ChenSiyun1234/nmos-ldo-board/docs/img/board_angle.png

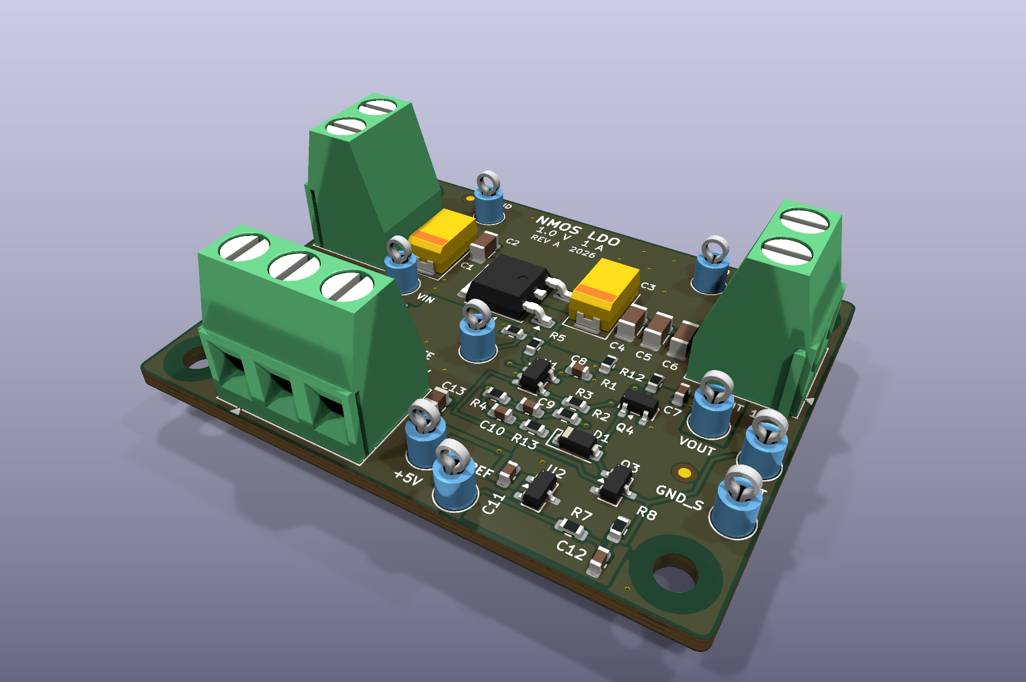
docs/img/board_angle.png
