ChenSiyun1234/nmos-ldo-board/fab/bom.csv

Reference | Qty | Value | Description | Manufacturer | MPN | Footprint
C1,C3 | 2 | 330uF 6.3V | Polymer tantalum capacitor 330uF 6.3V | KEMET | T520D337M006ATE015 | Capacitor_Tantalum_SMD:CP_EIA-7343-31_Kemet-D
C2,C4,C5,C6 | 4 | 47uF 6.3V | Ceramic capacitor 47uF 6.3V | Murata | GRM31CR60J476ME19L | Capacitor_SMD:C_1206_3216Metric
C7,C8,C11,C14 | 4 | 0.1uF | Ceramic capacitor 0.1uF | Murata | GRM188R71C104KA01D | Capacitor_SMD:C_0603_1608Metric
C9 | 1 | 1nF C0G | Ceramic capacitor 1nF C0G | Murata | GRM1885C1H102JA01D | Capacitor_SMD:C_0603_1608Metric
C10 | 1 | 3.3pF C0G | Ceramic capacitor 3.3pF C0G | Murata | GRM1885C1H3R3CA01D | Capacitor_SMD:C_0603_1608Metric
C12 | 1 | 0.47uF | Ceramic capacitor 0.47uF | Murata | GRM188R71C474KA88D | Capacitor_SMD:C_0603_1608Metric
C13 | 1 | 10uF 16V | Ceramic capacitor 10uF 16V | Murata | GRM21BR61C106KE15L | Capacitor_SMD:C_0805_2012Metric
D1 | 1 | 1N4148W | Switching diode, 100 V, 300 mA, SOD-123 | Diodes Incorporated | 1N4148W-7-F | Diode_SMD:D_SOD-123
J1 | 1 | VIN 1.5-2.0 V | Screw terminal, 2 pole, 5.08 mm | Phoenix Contact | 1715721 | TerminalBlock_Phoenix:TerminalBlock_Phoenix_MKDS-1,5-2-5.08_1x02_P5.08mm_Horizontal
J2 | 1 | VOUT 1.0 V 1 A | Screw terminal, 2 pole, 5.08 mm | Phoenix Contact | 1715721 | TerminalBlock_Phoenix:TerminalBlock_Phoenix_MKDS-1,5-2-5.08_1x02_P5.08mm_Horizontal
J3 | 1 | BIAS 5 V / EN | Screw terminal, 3 pole, 5.08 mm | Phoenix Contact | 1715734 | TerminalBlock_Phoenix:TerminalBlock_Phoenix_MKDS-1,5-3-5.08_1x03_P5.08mm_Horizontal
Q1 | 1 | IRLR024N | N-channel logic level MOSFET, 55 V, 65 mohm, DPAK | Infineon | IRLR024NTRPBF | Package_TO_SOT_SMD:TO-252-2
Q2,Q3,Q4 | 3 | BSS138 | 50V Vds, 0.22A Id, N-Channel MOSFET, SOT-23 | onsemi | BSS138 | Package_TO_SOT_SMD:SOT-23
R1 | 1 | 200 | Resistor 200, 0603 | Yageo | RC0603FR-07200RL | Resistor_SMD:R_0603_1608Metric
R2 | 1 | 2.55k 0.1% | Resistor 2.55k 0.1%, 0603 | Yageo | RT0603BRD072K55L | Resistor_SMD:R_0603_1608Metric
R3 | 1 | 10.2k 0.1% | Resistor 10.2k 0.1%, 0603 | Yageo | RT0603BRD0710K2L | Resistor_SMD:R_0603_1608Metric
R4 | 1 | 127k | Resistor 127k, 0603 | Yageo | RC0603FR-07127KL | Resistor_SMD:R_0603_1608Metric
R5 | 1 | 47 | Resistor 47, 0603 | Yageo | RC0603FR-0747RL | Resistor_SMD:R_0603_1608Metric
R6,R9,R13 | 3 | 100k | Resistor 100k, 0603 | Yageo | RC0603FR-07100KL | Resistor_SMD:R_0603_1608Metric
R7 | 1 | 5.62k 0.1% | Resistor 5.62k 0.1%, 0603 | Yageo | RT0603BRD075K62L | Resistor_SMD:R_0603_1608Metric
R8 | 1 | 10k 0.1% | Resistor 10k 0.1%, 0603 | Yageo | RT0603BRD0710KL | Resistor_SMD:R_0603_1608Metric
R10 | 1 | 4.7k | Resistor 4.7k, 0603 | Yageo | RC0603FR-074K7L | Resistor_SMD:R_0603_1608Metric
R11,R15 | 2 | 10k | Resistor 10k, 0603 | Yageo | RC0603FR-0710KL | Resistor_SMD:R_0603_1608Metric
R12 | 1 | 22 | Resistor 22, 0603 | Yageo | RC0603FR-0722RL | Resistor_SMD:R_0603_1608Metric
R14 | 1 | 23.2k | Resistor 23.2k, 0603 | Yageo | RC0603FR-0723K2L | Resistor_SMD:R_0603_1608Metric
TP1 | 1 | VIN | Test point, red | Keystone Electronics | 5005 | TestPoint:TestPoint_Keystone_5005-5009_Compact
TP2 | 1 | VOUT | Test point, red | Keystone Electronics | 5005 | TestPoint:TestPoint_Keystone_5005-5009_Compact
TP3 | 1 | GATE | Test point, white | Keystone Electronics | 5007 | TestPoint:TestPoint_Keystone_5005-5009_Compact
TP4 | 1 | VSET | Test point, white | Keystone Electronics | 5007 | TestPoint:TestPoint_Keystone_5005-5009_Compact
TP5 | 1 | VREF | Test point, white | Keystone Electronics | 5007 | TestPoint:TestPoint_Keystone_5005-5009_Compact
TP6 | 1 | +5V | Test point, red | Keystone Electronics | 5005 | TestPoint:TestPoint_Keystone_5005-5009_Compact
TP7 | 1 | EN_INT | Test point, white | Keystone Electronics | 5007 | TestPoint:TestPoint_Keystone_5005-5009_Compact
TP8,TP9 | 2 | GND | Test point, black | Keystone Electronics | 5006 | TestPoint:TestPoint_Keystone_5005-5009_Compact
TP10 | 1 | GND_S | Test point, black | Keystone Electronics | 5006 | TestPoint:TestPoint_Keystone_5005-5009_Compact
U1 | 1 | OPA365 | 50-MHz, Zero-Crossover, Low-Distortion, High CMRR, RRI/O, Single-Supply, SOT-23-5 | Texas Instruments | OPA365AIDBVR | Package_TO_SOT_SMD:SOT-23-5
U2 | 1 | REF3012 | 1.25 V voltage reference, 0.2 % initial accuracy, SOT-23-3 | Texas Instruments | REF3012AIDBZR | Package_TO_SOT_SMD:SOT-23
U3 | 1 | TPS3808G01 | Low-Quiescent-Current, Programmable-Delay Supervisory Circuit, SOT-23-6 | Texas Instruments | TPS3808G01DBVR | Package_TO_SOT_SMD:SOT-23-6
