ChenSiyun1234/nmos-ldo-board/fab/nmos-ldo-board.step

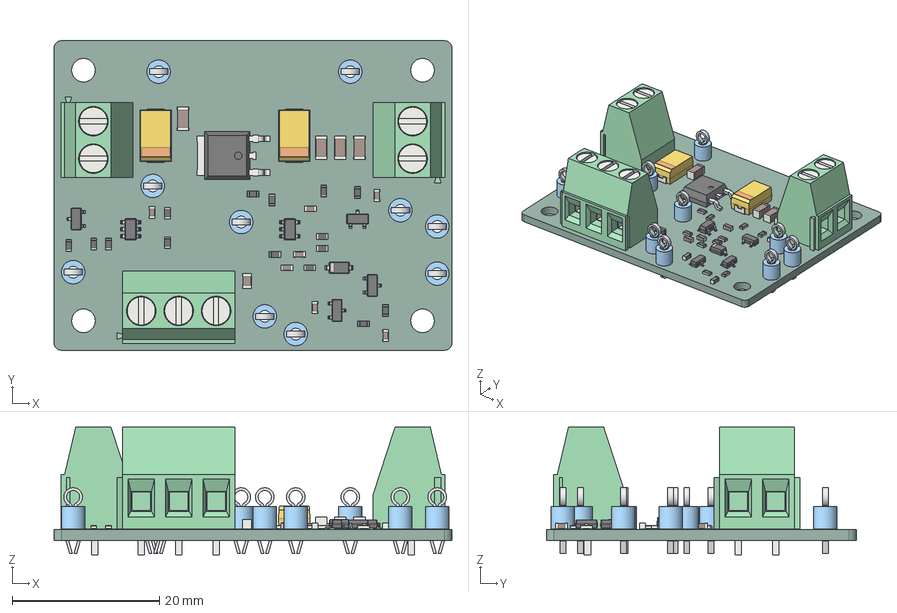
[picture p18: CAD file, 2026-10-25]
fab/nmos-ldo-board.step
54.0 x 42.0 x 17.3 mm
R_0603_1608Metric x 15
SOT-23 x 4
932d09b3-9c39-11ed-93f0-dde97e994e83_part
932d09b4-9c39-11ed-93f0-dde97e994e83_part
932d09b5-9c39-11ed-93f0-dde97e994e83_part
TestPoint_Keystone_5005_5009_Compact_cp x 10
C_0603_1608Metric x 7
C_1206_3216Metric x 4
TerminalBlock_Phoenix_MKDS-1,5-2-5.08_1x02_P5.08mm_Horizontal x 2
SOT-23-6
CP_EIA_7343_31_Kemet_D x 2
SOT-23-5
TerminalBlock_Phoenix_MKDS-1,5-3-5.08_1x03_P5.08mm_Horizontal
C_0805_2012Metric
D_SOD-123
nmos-ldo-board_PCB
