ChenSiyun1234/nmos-ldo-board/results/data/dropout.csv

iload_A | vin_V | vout_V | gate_V
0.5 | 1.8 | 1.0002937863253518 | 3.069355323225135
0.5 | 1.7975 | 1.0002937863239716 | 3.06935651475801
0.5 | 1.7950000000000002 | 1.0002937863217827 | 3.069357706290885
0.5 | 1.7925000000000002 | 1.0002937863211776 | 3.069358659517185
0.5 | 1.7900000000000003 | 1.0002937863193913 | 3.0693603276632104
0.5 | 1.7875000000000003 | 1.000293786317035 | 3.0693615191960855
0.5 | 1.7850000000000004 | 1.000293786316437 | 3.069362472422385
0.5 | 1.7825000000000004 | 1.0002937863147248 | 3.0693639022618355
0.5 | 1.7800000000000005 | 1.000293786312855 | 3.0693650937947106
0.5 | 1.7775000000000005 | 1.000293786311274 | 3.0693665236341605
0.5 | 1.7750000000000006 | 1.0002937863098302 | 3.0693677151670355
0.5 | 1.7725000000000006 | 1.0002937863082741 | 3.0693689066999106
0.5 | 1.7700000000000007 | 1.000293786306912 | 3.0693698599262107
0.5 | 1.7675000000000007 | 1.000293786304827 | 3.0693715280722356
0.5 | 1.7650000000000008 | 1.0002937863033248 | 3.069372957911686
0.5 | 1.7625000000000008 | 1.0002937863019805 | 3.069374149444561
0.5 | 1.760000000000001 | 1.0002937863004697 | 3.069375102670861
0.5 | 1.757500000000001 | 1.0002937862985808 | 3.069376532510311
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
