ChenSiyun1234/nmos-ldo-board/results/data/esr_sweep.csv

iload_A | polymer_esr | ceramic_esr | fc_Hz | pm_deg | gm_dB
0.0 | 5m | 1m | 1826.0188496911894 | 56.898154601071084 | 63.425992948190434
0.0 | 10m | 1m | 1826.3650098651015 | 57.69778812037198 | 63.41583886677044
0.0 | 15m | 1m | 1827.1809024629865 | 58.50341880747936 | 63.404382976363806
0.0 | 25m | 1m | 1830.2108155259937 | 60.131864705264945 | 63.37796082067839
0.0 | 45m | 1m | 1841.9454702607914 | 63.453556384563896 | 63.313186285380866
0.0 | 5m | 3m | 1826.0086316117868 | 56.91202250096515 | 63.357754642730974
0.0 | 10m | 3m | 1826.3554779733297 | 57.711664299900306 | 63.36006009811232
0.0 | 15m | 3m | 1827.166597608544 | 58.51722368700966 | 63.36241494027992
0.0 | 25m | 3m | 1830.18680458524 | 60.145529539862736 | 63.36393981122098
0.0 | 45m | 3m | 1841.889726335726 | 63.46674517907063 | 63.35510015854544
0.0 | 5m | 10m | 1825.971712577662 | 56.96054246544074 | 63.506847548535454
0.0 | 10m | 10m | 1826.301945667641 | 57.75992336623915 | 63.51114649653458
0.0 | 15m | 10m | 1827.096337745821 | 58.56522559054669 | 63.51433828193728
0.0 | 25m | 10m | 1830.0879647963125 | 60.19311681072904 | 63.51742583988098
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
