ChenSiyun1234/nmos-ldo-board/results/data/line_regulation.csv

iload_A | vin_V | vout_V
0.0 | 1.5 | 1.0002942954888567
0.0 | 1.51 | 1.000294295605272
0.0 | 1.52 | 1.000294295605272
0.0 | 1.53 | 1.0002942958381027
0.0 | 1.54 | 1.0002942958381027
0.0 | 1.55 | 1.0002942958381027
0.0 | 1.56 | 1.0002942958381027
0.0 | 1.57 | 1.0002942957216874
0.0 | 1.58 | 1.0002942957216874
0.0 | 1.59 | 1.0002942957216874
0.0 | 1.6 | 1.0002942957216874
0.0 | 1.61 | 1.0002942958381027
0.0 | 1.62 | 1.0002942958381027
0.0 | 1.6300000000000001 | 1.0002942958381027
0.0 | 1.6400000000000001 | 1.0002942958381027
0.0 | 1.6500000000000001 | 1.000294295954518
0.0 | 1.6600000000000001 | 1.0002942957216874
0.0 | 1.6700000000000002 | 1.0002942958381027
0.0 | 1.6800000000000002 | 1.0002942958381027
0.0 | 1.6900000000000002 | 1.0002942957216874
0.0 | 1.7000000000000002 | 1.000294295954518
0.0 | 1.7100000000000002 | 1.0002942957216874
0.0 | 1.7200000000000002 | 1.0002942958381027
0.0 | 1.7300000000000002 | 1.0002942958381027
0.0 | 1.7400000000000002 | 1.0002942957216874
0.0 | 1.7500000000000002 | 1.0002942957216874
0.0 | 1.7600000000000002 | 1.0002942958381027
0.0 | 1.7700000000000002 | 1.0002942957216874
0.0 | 1.7800000000000002 | 1.0002942958381027
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
