ChenSiyun1234/nmos-ldo-board/results/data/line_transient_1000mA.csv

time_s | vin_V | vout_V
0.0 | 1.4997487166194148 | 1.0002936067524995
4e-08 | 1.499748716549771 | 1.000293609384279
2.3e-07 | 1.499748716586196 | 1.0002936081992266
4.3e-07 | 1.4997487166330188 | 1.0002936084642515
6.300000000000002e-07 | 1.4997487167030263 | 1.0002936088248713
8.300000000000004e-07 | 1.4997487167857058 | 1.0002936090414323
1.0300000000000005e-06 | 1.4997487168571841 | 1.0002936091225465
1.2300000000000003e-06 | 1.499748716898599 | 1.0002936091036165
1.43e-06 | 1.4997487169035881 | 1.0002936090214871
1.52375e-06 | 1.4997487168934518 | 1.0002936089702452
1.7237499999999998e-06 | 1.4997487168542458 | 1.0002936088510632
1.9237499999999996e-06 | 1.4997487168004862 | 1.0002936087344094
2.1237499999999994e-06 | 1.4997487167459678 | 1.0002936086338048
2.323749999999999e-06 | 1.4997487167017671 | 1.0002936085566076
2.523749999999999e-06 | 1.4997487166743222 | 1.0002936085048564
2.617499999999999e-06 | 1.4997487166654258 | 1.000293608488821
2.817499999999999e-06 | 1.4997487166613912 | 1.0002936084707272
2.911249999999999e-06 | 1.4997487166633858 | 1.0002936084685352
3.111249999999999e-06 | 1.4997487166738863 | 1.0002936084744674
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
