ChenSiyun1234/nmos-ldo-board/results/data/line_transient_10mA.csv

time_s | vin_V | vout_V
0.0 | 1.499996218692085 | 1.0002942148130387
7.286845330898808e-09 | 1.4999962249655112 | 1.000294332131439
1.875265657264858e-08 | 1.4999961988136157 | 1.0002943904555028
6.937699842648432e-08 | 1.4999962120252441 | 1.0002941300217592
2.1444161880927042e-07 | 1.4999962093487693 | 1.0002942383157376
4.144416188092704e-07 | 1.4999962075712905 | 1.0002942666273207
6.144416188092705e-07 | 1.4999962081840397 | 1.0002942842239644
8.144416188092707e-07 | 1.4999962104266973 | 1.0002942995029835
1.0144416188092707e-06 | 1.4999962132450329 | 1.0002943131569146
1.2144416188092705e-06 | 1.4999962157340503 | 1.0002943254033105
1.4144416188092703e-06 | 1.499996217365585 | 1.000294336433911
1.61444161880927e-06 | 1.4999962180122322 | 1.0002943464260396
1.8144416188092698e-06 | 1.4999962178470567 | 1.0002943555378447
2.01444161880927e-06 | 1.4999962172010284 | 1.0002943639069737
2.2144416188092696e-06 | 1.499996216416777 | 1.000294371651693
2.4144416188092694e-06 | 1.4999962157559916 | 1.000294378872469
2.614441618809269e-06 | 1.4999962153563156 | 1.0002943856542026
2.814441618809269e-06 | 1.4999962152384627 | 1.000294392068174
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
