ChenSiyun1234/nmos-ldo-board/results/data/load_regulation.csv

iload_A | vout_J2_V | vout_caps_V | q1_source_V
0.0 | 1.000294295605272 | 1.0002944211507245 | 1.0002995010887399
0.01 | 1.0002942148130387 | 1.0003103404056575 | 1.0003254204527483
0.02 | 1.0002941739512607 | 1.0003262996499462 | 1.0003513798431252
0.03 | 1.000294145080261 | 1.00034227062633 | 1.0003773508039786
0.04 | 1.0002941192360595 | 1.0003582447083847 | 1.0004033249198137
0.05 | 1.0002941008424386 | 1.0003742265244124 | 1.000429306946781
0.060000000000000005 | 1.0002940852427855 | 1.000390210896766 | 1.0004552913815603
0.07 | 1.000294070225209 | 1.0004061954864465 | 1.0004812758056987
0.08 | 1.0002940566046163 | 1.0004221824123394 | 1.000507263153081
0.09 | 1.0002940440317616 | 1.0004381700091731 | 1.0005332509359068
0.09999999999999999 | 1.0002940323902294 | 1.0004541577304227 | 1.0005592383388342
0.10999999999999999 | 1.0002940217964351 | 1.0004701473936117 | 1.000585228242586
0.11999999999999998 | 1.0002940114354715 | 1.0004861363420483 | 1.0006112168393422
0.12999999999999998 | 1.000294001889415 | 1.0005021274905597 | 1.0006372085019144
0.13999999999999999 | 1.0002939926926047 | 1.000518118640661 | 1.0006631999487912
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
