ChenSiyun1234/nmos-ldo-board/results/thermal/copper_B_Cu.png

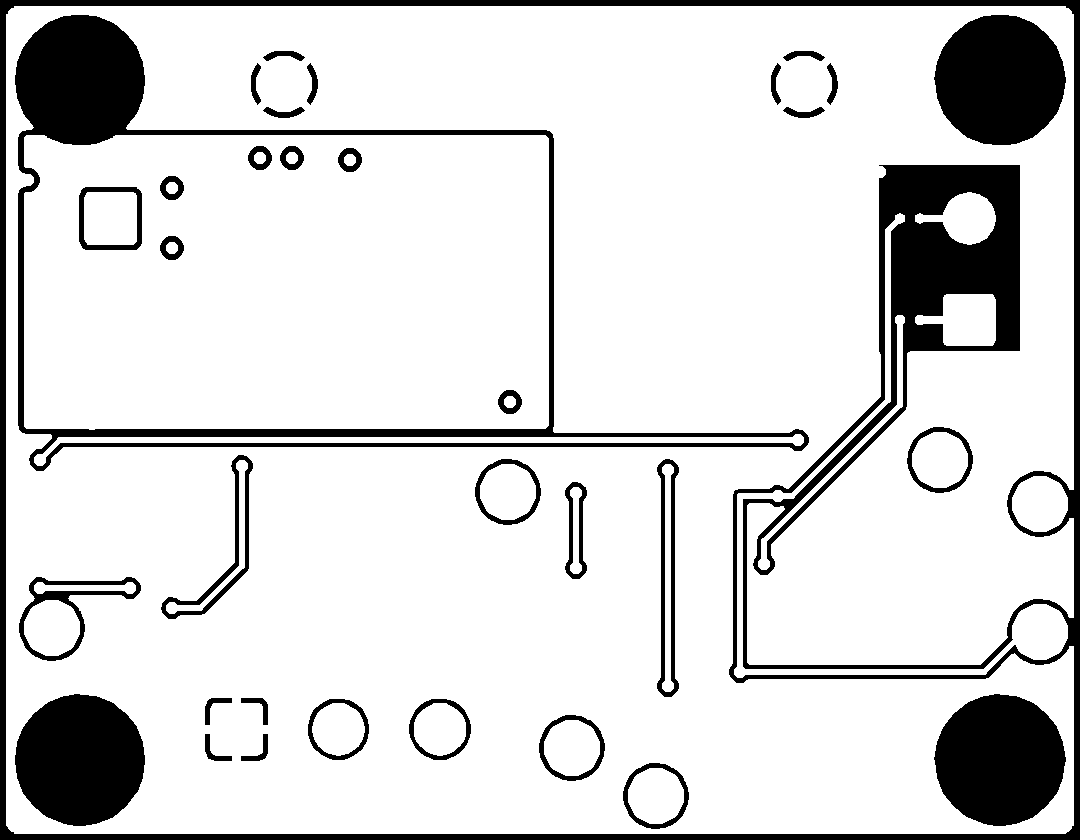
results/thermal/copper_B_Cu.png
