ChenSiyun1234/nmos-ldo-board/results/thermal/copper_F_Cu.png

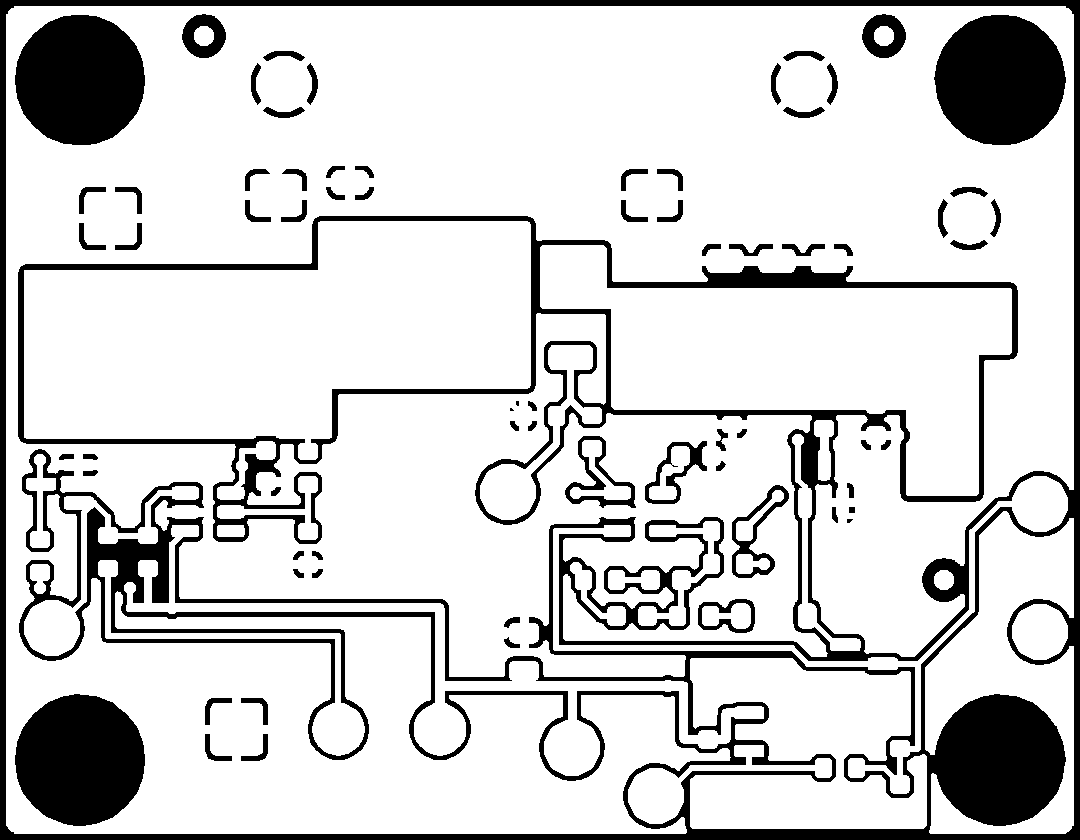
results/thermal/copper_F_Cu.png
