ChenSiyun1234/nmos-ldo-board/results/thermal/copper_In1_Cu.png

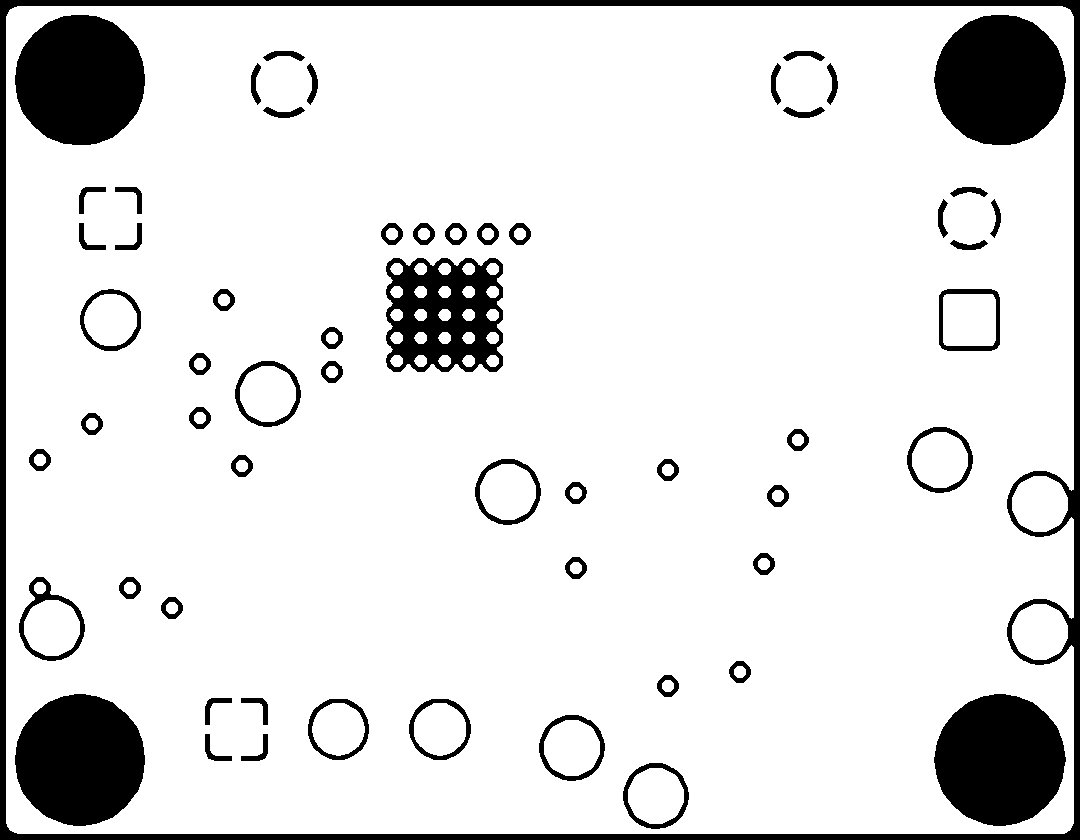
results/thermal/copper_In1_Cu.png
