ChenSiyun1234/nmos-ldo-board/hardware/nmos-ldo-board.kicad_pcb

## KiCad design hardware/nmos-ldo-board.kicad_pcb (2026-10-25)

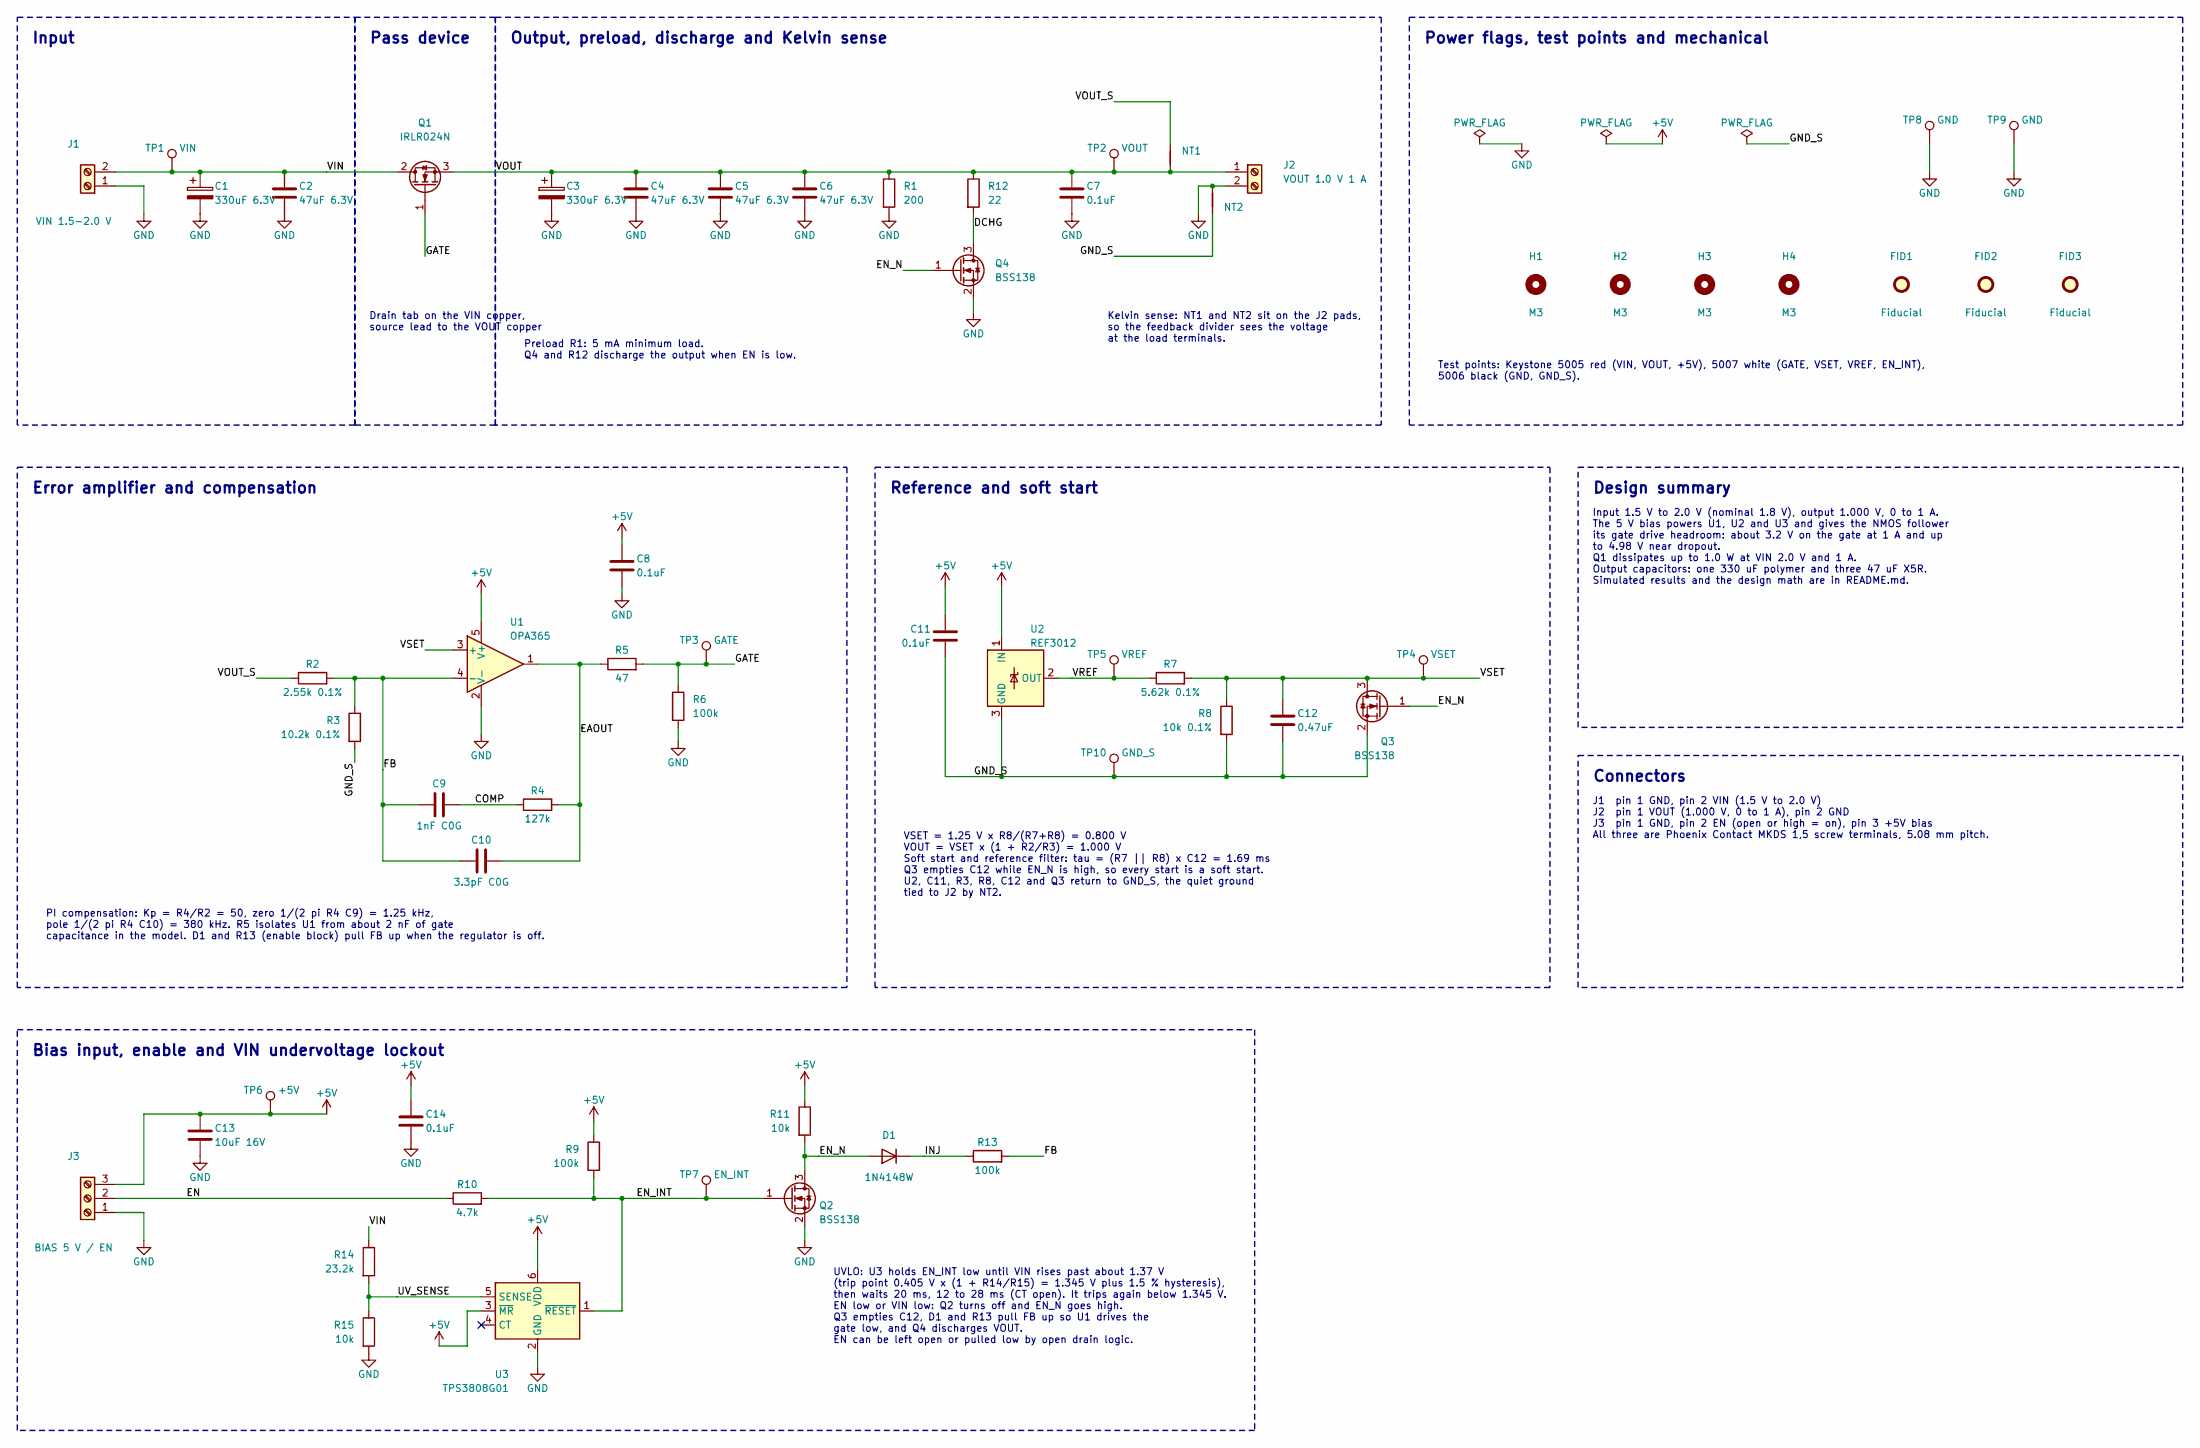
[picture p23: schematic nmos-ldo-board.kicad_sch, NMOS LDO board, 1.0 V at 1 A]

Parts:
C1, C3: 330uF 6.3V; CP_EIA-7343-31_Kemet-D; MPN T520D337M006ATE015
C2, C4, C5, C6: 47uF 6.3V; C_1206_3216Metric; MPN GRM31CR60J476ME19L
C7, C8, C11, C14: 0.1uF; C_0603_1608Metric; MPN GRM188R71C104KA01D
C9: 1nF C0G; C_0603_1608Metric; MPN GRM1885C1H102JA01D
C10: 3.3pF C0G; C_0603_1608Metric; MPN GRM1885C1H3R3CA01D
C12: 0.47uF; C_0603_1608Metric; MPN GRM188R71C474KA88D
C13: 10uF 16V; C_0805_2012Metric; MPN GRM21BR61C106KE15L
D1: 1N4148W; D_SOD-123; MPN 1N4148W-7-F
FID1, FID2, FID3: Fiducial; Fiducial_1mm_Mask2mm
H1, H2, H3, H4: M3; MountingHole_3.2mm_M3
J1: VIN 1.5-2.0 V; TerminalBlock_Phoenix_MKDS-1,5-2-5.08_1x02_P5.08mm_Horizont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; MPN 1715721
J2: VOUT 1.0 V 1 A; TerminalBlock_Phoenix_MKDS-1,5-2-5.08_1x02_P5.08mm_Horizont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; MPN 1715721
J3: BIAS 5 V / EN; TerminalBlock_Phoenix_MKDS-1,5-3-5.08_1x03_P5.08mm_Horizont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; MPN 1715734
NT1, NT2: NetTie; NetTie-2_SMD_Pad0.5mm
Q1: IRLR024N; TO-252-2; MPN IRLR024NTRPBF
Q2, Q3, Q4: BSS138; SOT-23; MPN BSS138
R1: 200; R_0603_1608Metric; MPN RC0603FR-07200RL
R2: 2.55k 0.1%; R_0603_1608Metric; MPN RT0603BRD072K55L
R3: 10.2k 0.1%; R_0603_1608Metric; MPN RT0603BRD0710K2L
R4: 127k; R_0603_1608Metric; MPN RC0603FR-07127KL
R5: 47; R_0603_1608Metric; MPN RC0603FR-0747RL
R6, R9, R13: 100k; R_0603_1608Metric; MPN RC0603FR-07100KL
R7: 5.62k 0.1%; R_0603_1608Metric; MPN RT0603BRD075K62L
R8: 10k 0.1%; R_0603_1608Metric; MPN RT0603BRD0710KL
R10: 4.7k; R_0603_1608Metric; MPN RC0603FR-074K7L
R11, R15: 10k; R_0603_1608Metric; MPN RC0603FR-0710KL
R12: 22; R_0603_1608Metric; MPN RC0603FR-0722RL
R14: 23.2k; R_0603_1608Metric; MPN RC0603FR-0723K2L
TP1: VIN; TestPoint_Keystone_5005-5009_Compact; MPN 5005
TP2: VOUT; TestPoint_Keystone_5005-5009_Compact; MPN 5005
TP3: GATE; TestPoint_Keystone_5005-5009_Compact; MPN 5007
TP4: VSET; TestPoint_Keystone_5005-5009_Compact; MPN 5007
TP5: VREF; TestPoint_Keystone_5005-5009_Compact; MPN 5007
TP6: +5V; TestPoint_Keystone_5005-5009_Compact; MPN 5005
TP7: EN_INT; TestPoint_Keystone_5005-5009_Compact; MPN 5007
TP8, TP9: GND; TestPoint_Keystone_5005-5009_Compact; MPN 5006
TP10: GND_S; TestPoint_Keystone_5005-5009_Compact; MPN 5006
U1: OPA365; SOT-23-5; MPN OPA365AIDBVR
U2: REF3012; SOT-23; MPN REF3012AIDBZR
U3: TPS3808G01; SOT-23-6; MPN TPS3808G01DBVR

Connections:
+5V: C8.1, C11.1, C13.1, C14.1, J3.3, R9.1, R11.1, TP6.1, U1.5 (V+), U2.1 (IN), U3.3 (~MR), U3.6 (VDD)
/COMP: C9.2, R4.1
/DCHG: Q4.3 (D), R12.2
/EAOUT: C10.2, R4.2, R5.1, U1.1
/EN: J3.2, R10.1
/EN_INT: Q2.1 (G), R9.2, R10.2, TP7.1, U3.1 (~RESET)
/EN_N: D1.2 (A), Q2.3 (D), Q3.1 (G), Q4.1 (G), R11.2
/FB: C9.1, C10.1, R2.2, R3.1, R13.2, U1.4 (-)
/GATE: Q1.1 (G), R5.2, R6.1, TP3.1
/GND_S: C11.2, C12.2, NT2.2, Q3.2 (S), R3.2, R8.2, TP10.1, U2.3 (GND)
/INJ: D1.1 (K), R13.1
/UV_SENSE: R14.2, R15.1, U3.5 (SENSE)
/VIN: C1.1, C2.1, J1.2, Q1.2 (D), R14.1, TP1.1
/VOUT: C3.1, C4.1, C5.1, C6.1, C7.1, J2.1, NT1.1, Q1.3 (S), R1.1, R12.1, TP2.1
/VOUT_S: NT1.2, R2.1
/VREF: R7.1, TP5.1, U2.2 (OUT)
/VSET: C12.1, Q3.3 (D), R7.2, R8.1, TP4.1, U1.3 (+)
GND: C1.2, C2.2, C3.2, C4.2, C5.2, C6.2, C7.2, C8.2, C13.2, C14.2, J1.1, J2.2, J3.1, NT2.1, Q2.2 (S), Q4.2 (S), R1.2, R6.2, R15.2, TP8.1, TP9.1, U1.2 (V-), U3.2 (GND)

Notes on the sheet:
Input
Pass device
Output, preload, discharge and Kelvin sense
Power flags, test points and mechanical
Error amplifier and compensation
Reference and soft start
Design summary
Connectors
J1 pin 1 GND, pin 2 VIN (1.5 V to 2.0 V) J2 pin 1 VOUT (1.000 V, 0 to 1 A), pin 2 GND J3 pin 1 GND, pin 2 EN (open or high = on), pin 3 +5V bias All three are Phoenix Contact MKDS 1,5 screw terminals, 5.08 mm pitch.
Bias input, enable and VIN undervoltage lockout
Drain tab on the VIN copper, source lead to the VOUT copper
Preload R1: 5 mA minimum load. Q4 and R12 discharge the output when EN is low.
Kelvin sense: NT1 and NT2 sit on the J2 pads, so the feedback divider sees the voltage at the load terminals.
Test points: Keystone 5005 red (VIN, VOUT, +5V), 5007 white (GATE, VSET, VREF, EN_INT), 5006 black (GND, GND_S).
PI compensation: Kp = R4/R2 = 50, zero 1/(2 pi R4 C9) = 1.25 kHz, pole 1/(2 pi R4 C10) = 380 kHz. R5 isolates U1 from about 2 nF of gate capacitance in the model. D1 and R13 (enable block) pull FB up when the regulator is off.
VSET = 1.25 V x R8/(R7+R8) = 0.800 V VOUT = VSET x (1 + R2/R3) = 1.000 V Soft start and reference filter: tau = (R7 || R8) x C12 = 1.69 ms Q3 empties C12 while EN_N is high, so every start is a soft start. U2, C11, R3, R8, C12 and Q3 return to GND_S, the quiet ground tied to J2 by NT2.
Input 1.5 V to 2.0 V (nominal 1.8 V), output 1.000 V, 0 to 1 A. The 5 V bias powers U1, U2 and U3 and gives the NMOS follower its gate drive headroom: about 3.2 V on the gate at 1 A and up to 4.98 V near dropout. Q1 dissipates up to 1.0 W at VIN 2.0 V and 1 A. Output capacitors: one 330 uF polymer 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
UVLO: U3 holds EN_INT low until VIN rises past about 1.37 V (trip point 0.405 V x (1 + R14/R15) = 1.345 V plus 1.5 % hysteresis), then waits 20 ms, 12 to 28 ms (CT open). It trips again below 1.345 V. EN low or VIN low: Q2 turns off and EN_N goes high. Q3 empties C12, D1 and R13 pull FB up so U1 dr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

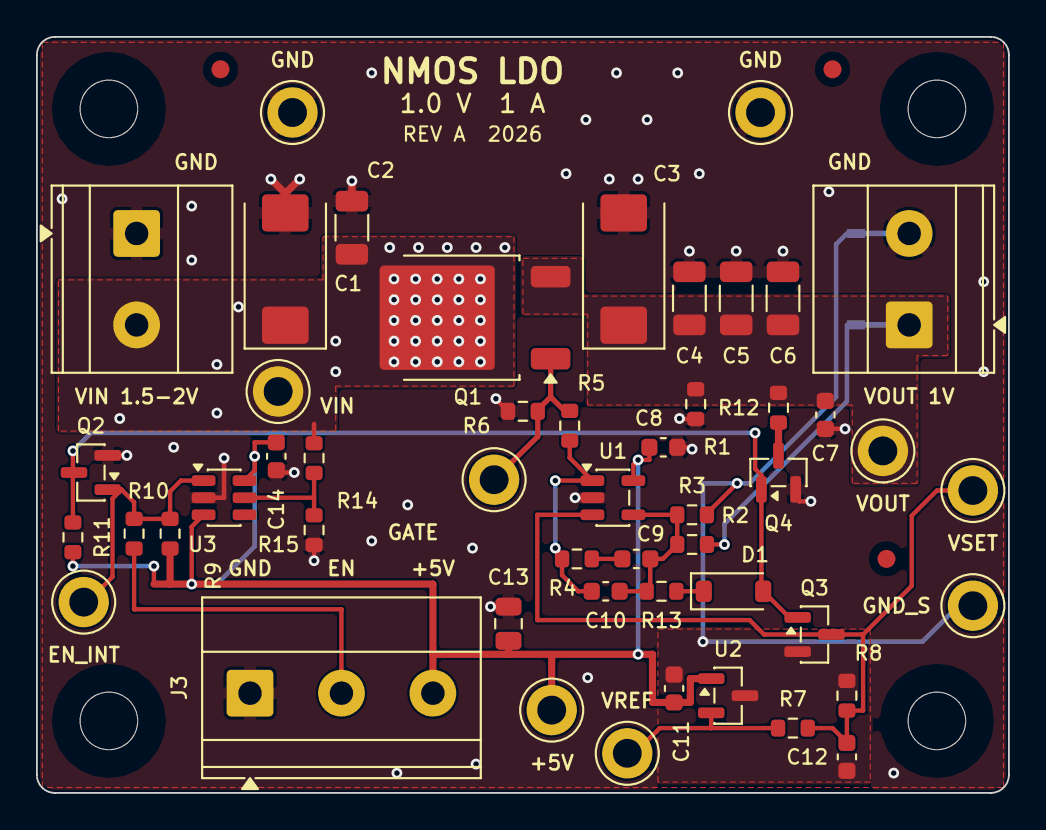
[picture p24: board nmos-ldo-board.kicad_pcb from above]

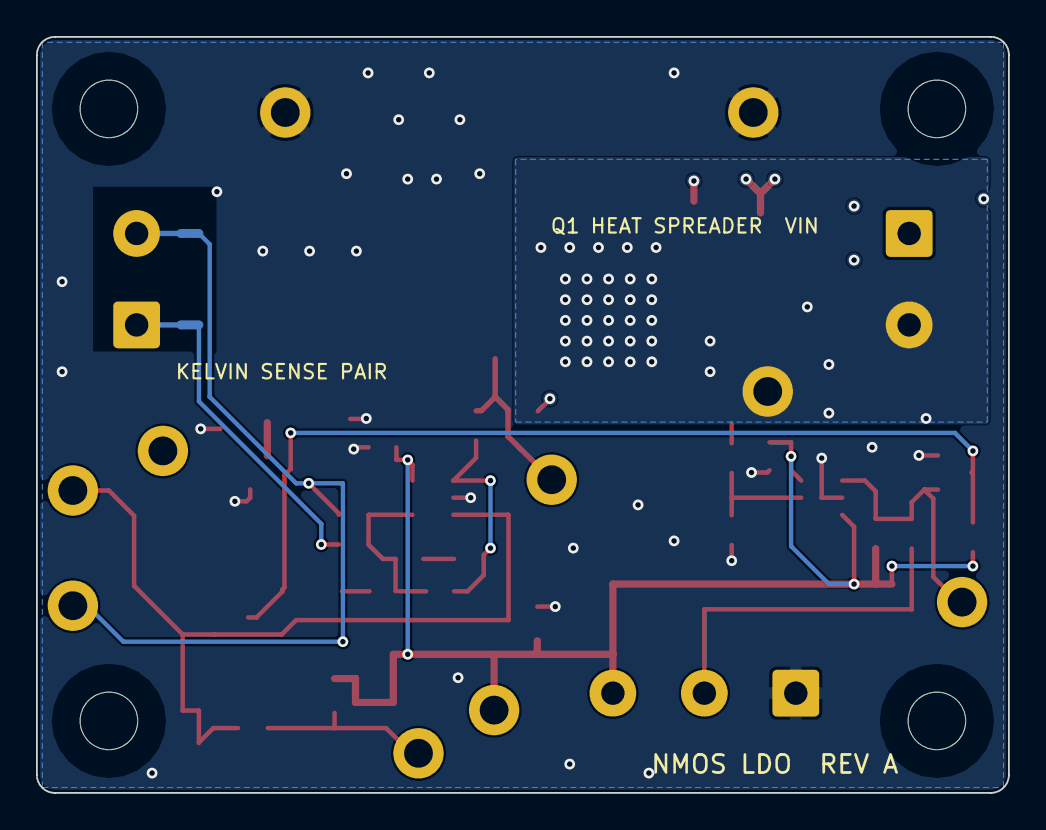
[picture p25: board nmos-ldo-board.kicad_pcb from below]

Board: 4 copper layers, 54.0 x 42.0 mm, 59 parts (2 on the bottom side), 18 nets.
